CCCPRabbit/ATmega328P_VS1003_SDCARD/FreeCAD/magnet.FCStd

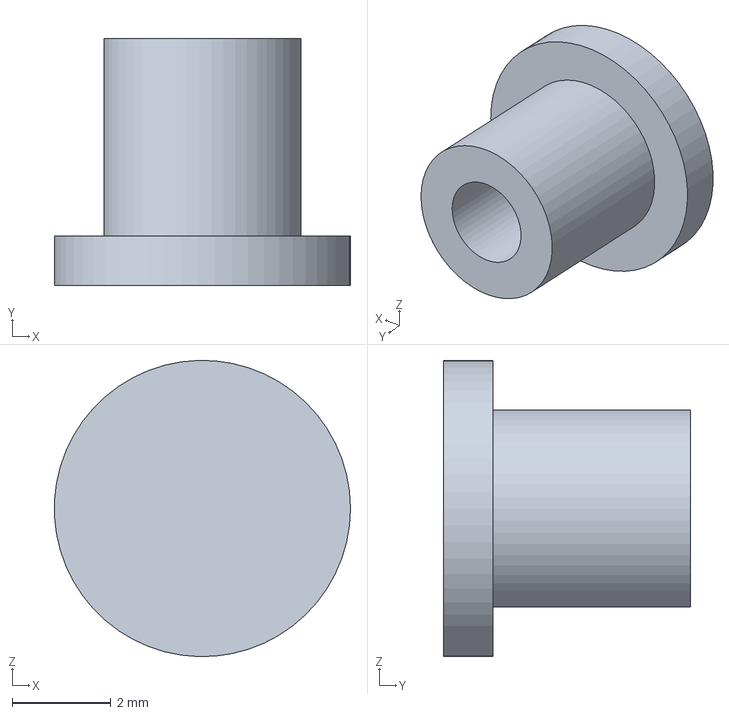
[picture p1: CAD file, 2026-07-08]
FreeCAD/magnet.FCStd
6.00 x 5.00 x 6.00 mm
