CCCPRabbit/ATmega328P_VS1003_SDCARD/(list of files, cad)

Other CAD files:
FreeCAD/magnet.3mf
