CCCPRabbit/ATmega328P_VS1003_SDCARD/KICAD/Encoder_20260515_/Encoder_20260515_.kicad_pcb

## KiCad design KICAD/Encoder_20260515_/Encoder_20260515_.kicad_pcb (2026-07-08)

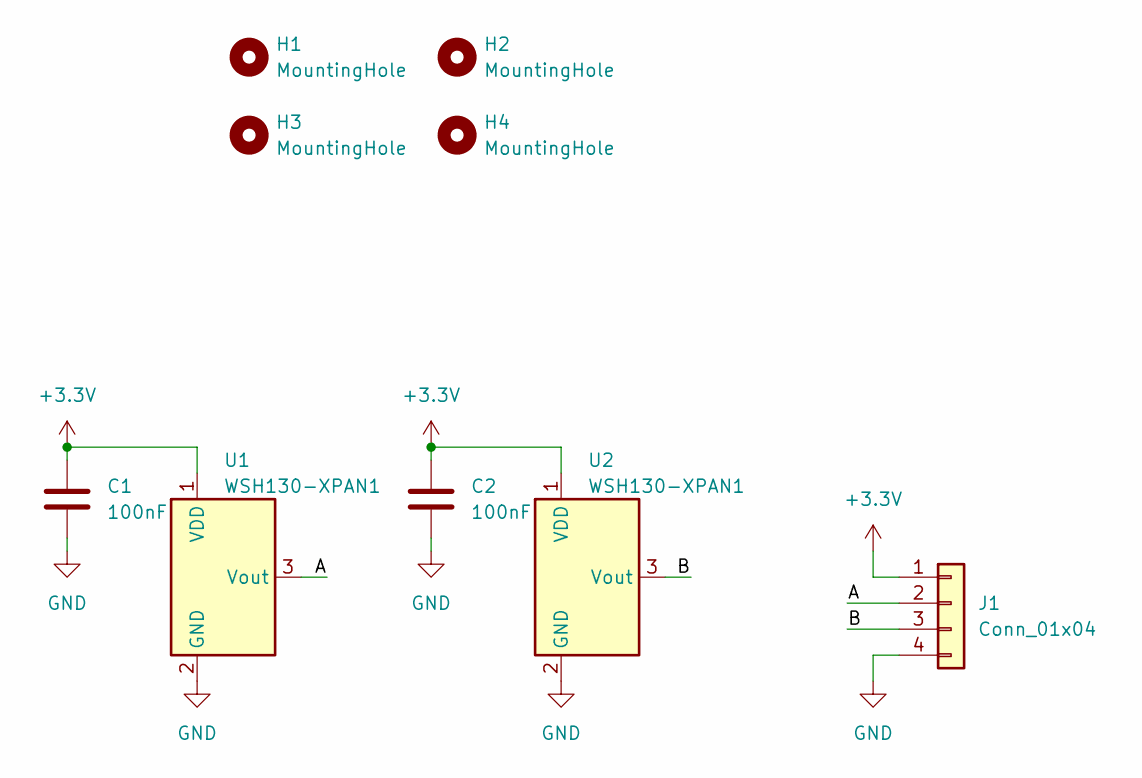
[picture p2: schematic Encoder_20260515_.kicad_sch, Encoder]

Parts:
C1, C2: 100nF; C_0603_1608Metric
H1, H2, H3, H4: MountingHole; MountingHole_2.2mm_M2
J1: Conn_01x04; Molex_PicoBlade_53047-0410_1x04_P1.25mm_Vertical
U1, U2: WSH130-XPAN1; TO-92S

Connections:
+3.3V: C1.1, C2.1, J1.1, U1.1 (VDD), U2.1 (VDD)
/A: J1.2, U1.3 (Vout)
/B: J1.3, U2.3 (Vout)
GND: C1.2, C2.2, J1.4, U1.2 (GND), U2.2 (GND)

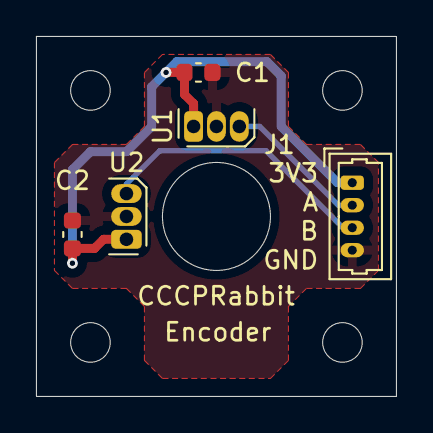
[picture p3: board Encoder_20260515_.kicad_pcb from above]

Board: 2 copper layers, 20.0 x 20.0 mm, 9 parts (0 on the bottom side), 4 nets.
