CCCPRabbit/ATmega328P_VS1003_SDCARD/KICAD/Magic_Conch_20260510_/Magic_Conch_20260510_.kicad_pcb

## KiCad design KICAD/Magic_Conch_20260510_/Magic_Conch_20260510_.kicad_pcb (2026-07-08)

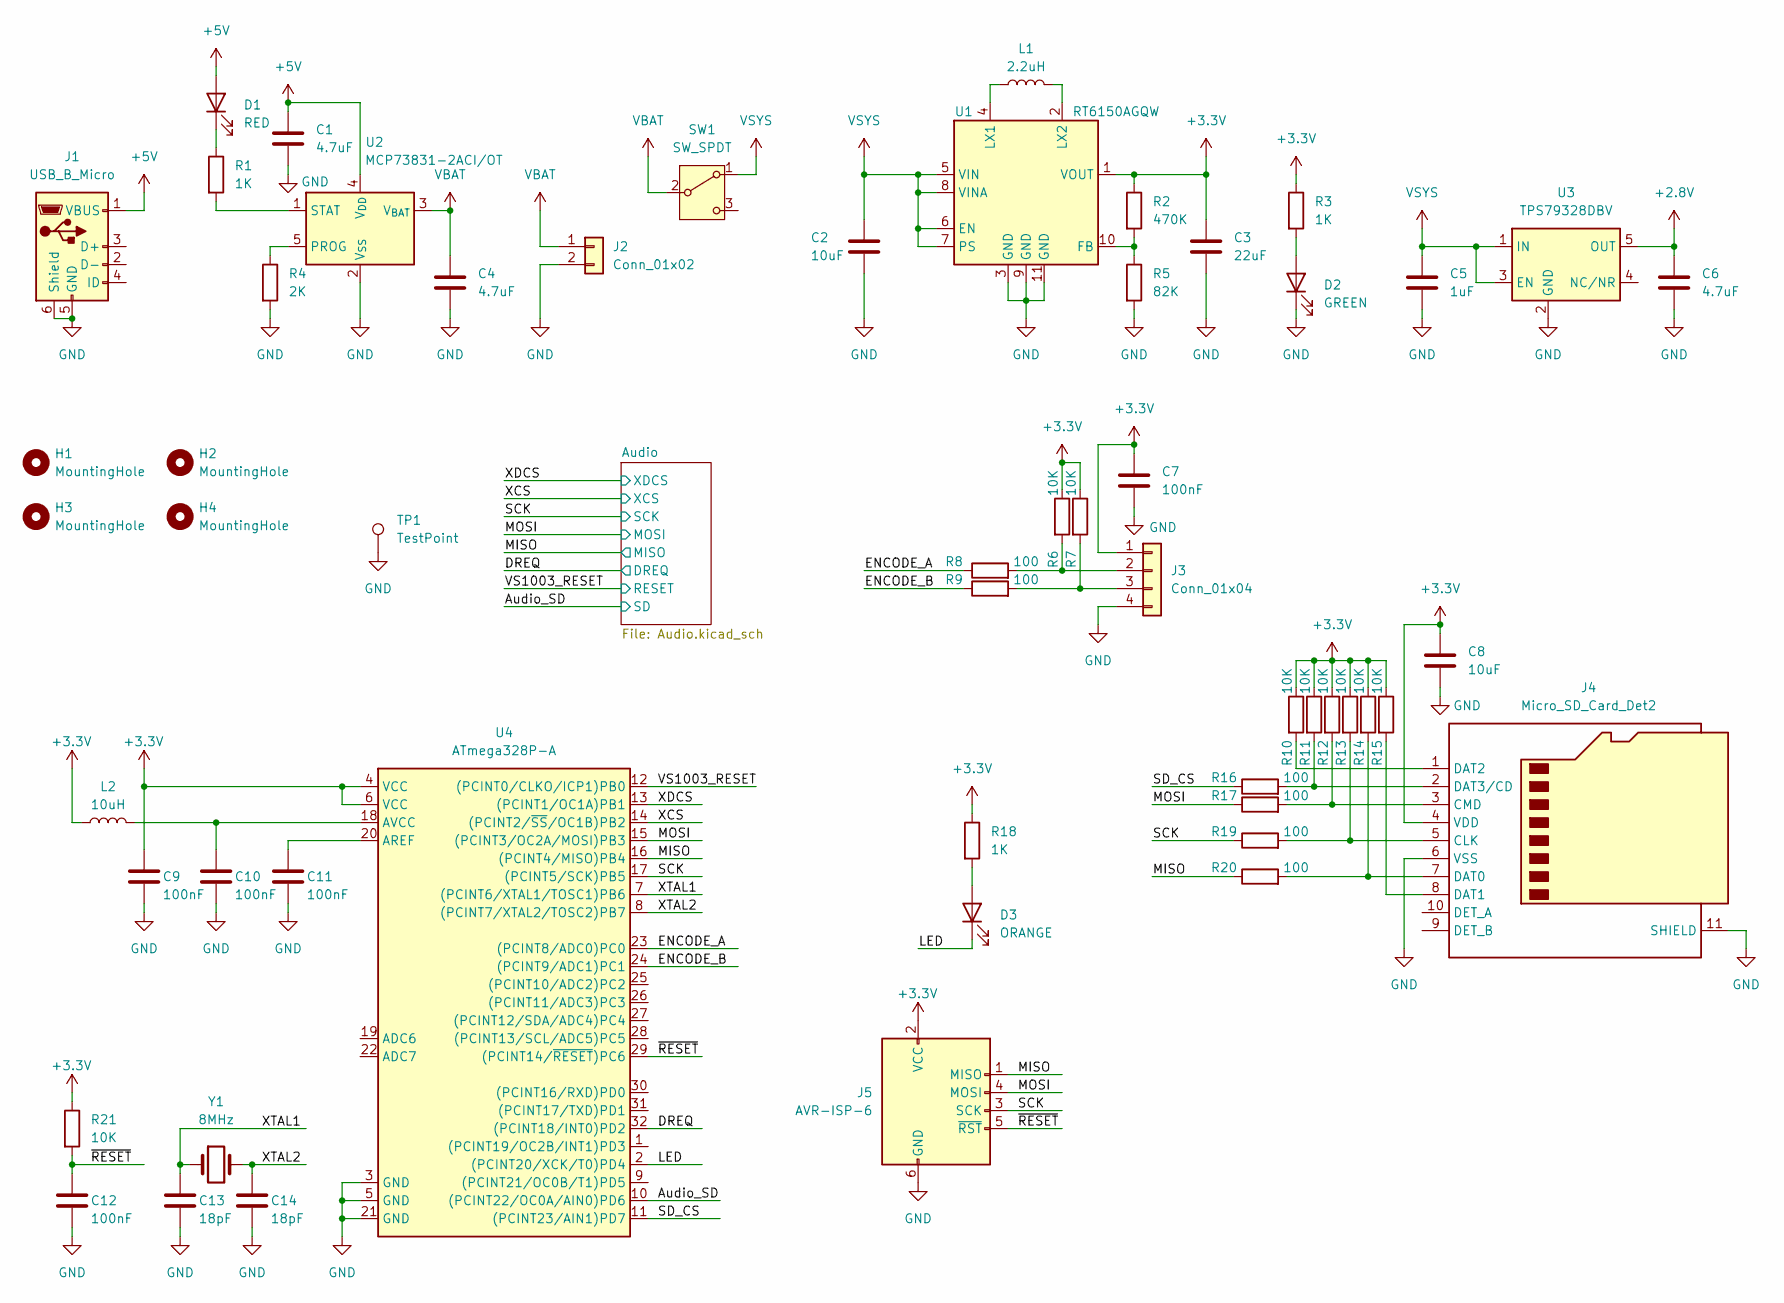
[picture p4: schematic Magic_Conch_20260510_.kicad_sch, Magic Conch]

Parts:
C1, C4, C6: 4.7uF; C_0603_1608Metric
C2, C8: 10uF; C_0603_1608Metric
C3: 22uF; C_0603_1608Metric
C5: 1uF; C_0603_1608Metric
C7, C9, C10, C11, C12: 100nF; C_0603_1608Metric
C13, C14: 18pF; C_0603_1608Metric
D1: RED; LED_0603_1608Metric
D2: GREEN; LED_0603_1608Metric
D3: ORANGE; LED_0603_1608Metric
H1, H2, H3, H4: MountingHole; MountingHole_3.2mm_M3
J1: USB_B_Micro; USB_Micro-B_Amphenol_10118194_Horizontal
J2: Conn_01x02; Molex_PicoBlade_53047-0210_1x02_P1.25mm_Vertical
J3: Conn_01x04; Molex_PicoBlade_53047-0410_1x04_P1.25mm_Vertical
J4: Micro_SD_Card_Det2; microSD_HC_Hirose_DM3AT-SF-PEJM5
J5: AVR-ISP-6; IDC-Header_2x03_P2.54mm_Vertical
L1: 2.2uH; L_1008_2520Metric
L2: 10uH; L_0603_1608Metric
R1, R3, R18: 1K; R_0603_1608Metric
R2: 470K; R_0603_1608Metric
R4: 2K; R_0603_1608Metric
R5: 82K; R_0603_1608Metric
R6, R7, R10, R11, R12, R13, R14, R15, R21: 10K; R_0603_1608Metric
R8, R9, R16, R17, R19, R20: 100; R_0603_1608Metric
SW1: SW_SPDT; MSL-1C2P(MID)-4mm
TP1: TestPoint; PinHeader_1x01_P2.54mm_Vertical
U1: RT6150AGQW; WDFN-10-1EP_3x3mm_P0.5mm_EP1.8x2.5mm
U2: MCP73831-2ACI/OT; SOT-23-5
U3: TPS79328DBV; SOT-23-5
U4: ATmega328P-A; TQFP-32_7x7mm_P0.8mm
Y1: 8MHz; Crystal_SMD_HC49-SD

Connections:
+2.8V: C6.1, U3.5 (OUT); also elsewhere on the board
+3.3V: C3.1, C7.1, C8.1, C9.1, J3.1, J4.4 (VDD), J5.2 (VCC), L2.1, R2.1, R3.1, R6.1, R7.1, R10.1, R11.1, R12.1, R13.1, R14.1, R15.1, R18.1, R21.1, U1.1 (VOUT), U4.4 (VCC), U4.6 (VCC); also elsewhere on the board
+5V: C1.1, D1.2 (A), J1.1 (VBUS), U2.4 (V_{DD})
/Audio_SD: U4.10 ((PCINT22/OC0A/AIN0)PD6); also elsewhere on the board
/DREQ: U4.32 ((PCINT18/INT0)PD2); also elsewhere on the board
/ENCODE_A: R8.1, U4.23 ((PCINT8/ADC0)PC0)
/ENCODE_B: R9.1, U4.24 ((PCINT9/ADC1)PC1)
/LED: D3.1 (K), U4.2 ((PCINT20/XCK/T0)PD4)
/MISO: J5.1 (MISO), R20.1, U4.16 ((PCINT4/MISO)PB4); also elsewhere on the board
/MOSI: J5.4 (MOSI), R17.1, U4.15 ((PCINT3/OC2A/MOSI)PB3); also elsewhere on the board
/SCK: J5.3 (SCK), R19.1, U4.17 ((PCINT5/SCK)PB5); also elsewhere on the board
/SD_CS: R16.1, U4.11 ((PCINT23/AIN1)PD7)
/VS1003_RESET: U4.12 ((PCINT0/CLKO/ICP1)PB0); also elsewhere on the board
/XCS: U4.14 ((PCINT2/~SS/OC1B)PB2); also elsewhere on the board
/XDCS: U4.13 ((PCINT1/OC1A)PB1); also elsewhere on the board
/XTAL1: C13.1, U4.7 ((PCINT6/XTAL1/TOSC1)PB6), Y1.1
/XTAL2: C14.1, U4.8 ((PCINT7/XTAL2/TOSC2)PB7), Y1.2
/~RESET: C12.1, J5.5 (~RST), R21.2, U4.29 ((PCINT14/~RESET)PC6)
GND: C1.2, C2.2, C3.2, C4.2, C5.2, C6.2, C7.2, C8.2, C9.2, C10.2, C11.2, C12.2, C13.2, C14.2, D2.1 (K), J1.5 (GND), J1.6 (Shield), J2.2, J3.4, J4.6 (VSS), J4.11 (SHIELD), J5.6 (GND), R4.2, R5.2, TP1.1, U1.3 (GND), U1.9 (GND), U1.11 (GND), U2.2 (V_{SS}), U3.2 (GND), U4.3 (GND), U4.5 (GND), U4.21 (GND); also elsewhere on the board
unnamed: D1.1 (K), R1.1
unnamed: D2.2 (A), R3.2
unnamed: D3.2 (A), R18.2
unnamed: J3.2, R6.2, R8.2
unnamed: J3.3, R7.2, R9.2
unnamed: J4.5 (CLK), R13.2, R19.2
unnamed: J4.3 (CMD), R12.2, R17.2
unnamed: J4.7 (DAT0), R14.2, R20.2
unnamed: J4.8 (DAT1), R15.2
unnamed: J4.1 (DAT2), R10.2
unnamed: J4.2 (DAT3/CD), R11.2, R16.2
unnamed: R2.2, R5.1, U1.10 (FB)
unnamed: L1.1, U1.4 (LX1)
unnamed: L1.2, U1.2 (LX2)
unnamed: R4.1, U2.5 (PROG)
unnamed: R1.2, U2.1 (STAT)
unnamed: C11.1, U4.20 (AREF)
unnamed: C10.1, L2.2, U4.18 (AVCC)
VBAT: C4.1, J2.1, SW1.2 (B), U2.3 (V_{BAT})
VSYS: C2.1, C5.1, SW1.1 (A), U1.5 (VIN), U1.6 (EN), U1.7 (PS), U1.8 (VINA), U3.1 (IN), U3.3 (EN)

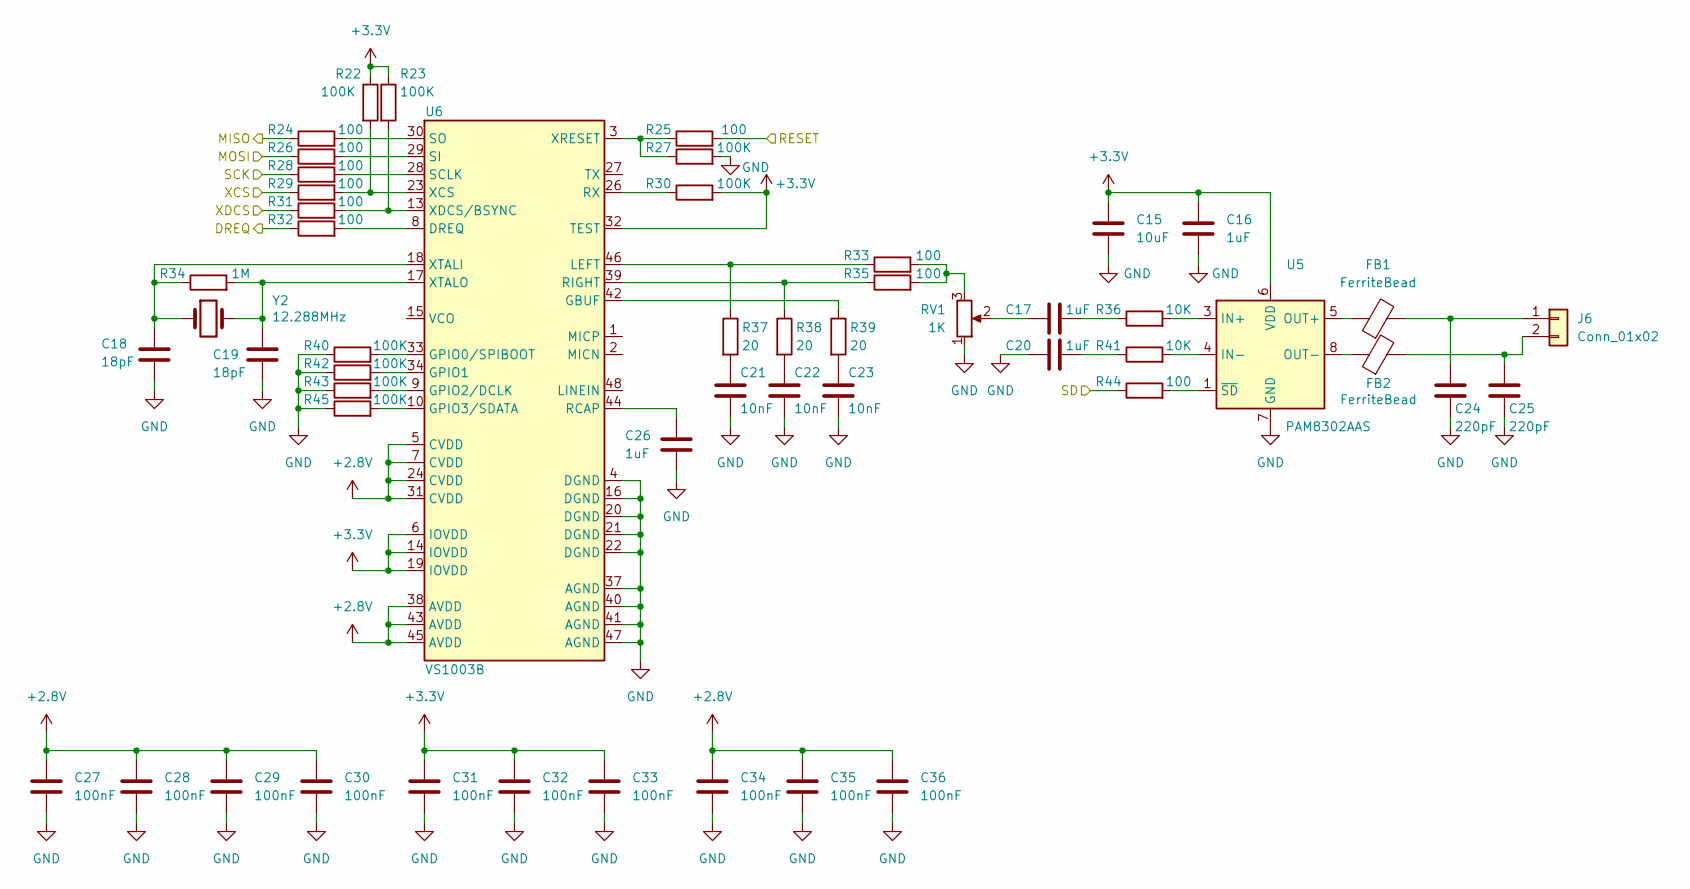
[picture p5: schematic Audio.kicad_sch]

Parts:
C15: 10uF; C_0603_1608Metric
C16, C17, C20, C26: 1uF; C_0603_1608Metric
C18, C19: 18pF; C_0603_1608Metric
C21, C22, C23: 10nF; C_0603_1608Metric
C24, C25: 220pF; C_0603_1608Metric
C27, C28, C29, C30, C31, C32, C33, C34, C35, C36: 100nF; C_0603_1608Metric
FB1, FB2: FerriteBead; L_0603_1608Metric
J6: Conn_01x02; Molex_PicoBlade_53047-0210_1x02_P1.25mm_Vertical
R22, R23, R27, R30, R40, R42, R43, R45: 100K; R_0603_1608Metric
R24, R25, R26, R28, R29, R31, R32, R33, R35, R44: 100; R_0603_1608Metric
R34: 1M; R_0603_1608Metric
R36, R41: 10K; R_0603_1608Metric
R37, R38, R39: 20; R_0603_1608Metric
RV1: 1K; Potentiometer_Bourns_3362P_Vertical
U5: PAM8302AAS; MSOP-8_3x3mm_P0.65mm
U6: VS1003B; LQFP-48_7x7mm_P0.5mm
Y2: 12.288MHz; Crystal_SMD_HC49-SD

Connections:
+2.8V: C27.1, C28.1, C29.1, C30.1, C34.1, C35.1, C36.2, U6.5 (CVDD), U6.7 (CVDD), U6.24 (CVDD), U6.31 (CVDD), U6.38 (AVDD), U6.43 (AVDD), U6.45 (AVDD); also elsewhere on the board
+3.3V: C15.1, C16.1, C31.1, C32.1, C33.1, R22.1, R23.1, R30.2, U5.6 (VDD), U6.6 (IOVDD), U6.14 (IOVDD), U6.19 (IOVDD), U6.32 (TEST); also elsewhere on the board
/Audio_SD: R44.1; also elsewhere on the board
/DREQ: R32.1; also elsewhere on the board
/MISO: R24.1; also elsewhere on the board
/MOSI: R26.1; also elsewhere on the board
/SCK: R28.1; also elsewhere on the board
/VS1003_RESET: R25.2; also elsewhere on the board
/XCS: R29.1; also elsewhere on the board
/XDCS: R31.1; also elsewhere on the board
GND: C15.2, C16.2, C18.2, C19.2, C20.1, C21.2, C22.2, C23.2, C24.2, C25.2, C26.2, C27.2, C28.2, C29.2, C30.2, C31.2, C32.2, C33.2, C34.2, C35.2, C36.1, R27.2, R40.1, R42.1, R43.1, R45.1, RV1.1, U5.7 (GND), U6.4 (DGND), U6.16 (DGND), U6.20 (DGND), U6.21 (DGND), U6.22 (DGND), U6.37 (AGND), U6.40 (AGND), U6.41 (AGND), U6.47 (AGND); also elsewhere on the board
unnamed: C17.1, RV1.2
unnamed: C17.2, R36.1
unnamed: C20.2, R41.1
unnamed: C21.1, R37.2
unnamed: C22.1, R38.2
unnamed: C23.1, R39.2
unnamed: C24.1, FB1.2, J6.1
unnamed: C25.1, FB2.2, J6.2
unnamed: R33.2, R35.2, RV1.3
unnamed: R36.2, U5.3 (IN+)
unnamed: R41.2, U5.4 (IN-)
unnamed: FB1.1, U5.5 (OUT+)
unnamed: FB2.1, U5.8 (OUT-)
unnamed: R44.2, U5.1 (~SD)
unnamed: R32.2, U6.8 (DREQ)
unnamed: R39.1, U6.42 (GBUF)
unnamed: R40.2, U6.33 (GPIO0/SPIBOOT)
unnamed: R42.2, U6.34 (GPIO1)
unnamed: R43.2, U6.9 (GPIO2/DCLK)
unnamed: R45.2, U6.10 (GPIO3/SDATA)
unnamed: R33.1, R37.1, U6.46 (LEFT)
unnamed: C26.1, U6.44 (RCAP)
unnamed: R35.1, R38.1, U6.39 (RIGHT)
unnamed: R30.1, U6.26 (RX)
unnamed: R28.2, U6.28 (SCLK)
unnamed: R26.2, U6.29 (SI)
unnamed: R24.2, U6.30 (SO)
unnamed: R22.2, R29.2, U6.23 (XCS)
unnamed: R23.2, R31.2, U6.13 (XDCS/BSYNC)
unnamed: R25.1, R27.1, U6.3 (XRESET)
unnamed: C18.1, R34.1, U6.18 (XTALI), Y2.1
unnamed: C19.1, R34.2, U6.17 (XTALO), Y2.2

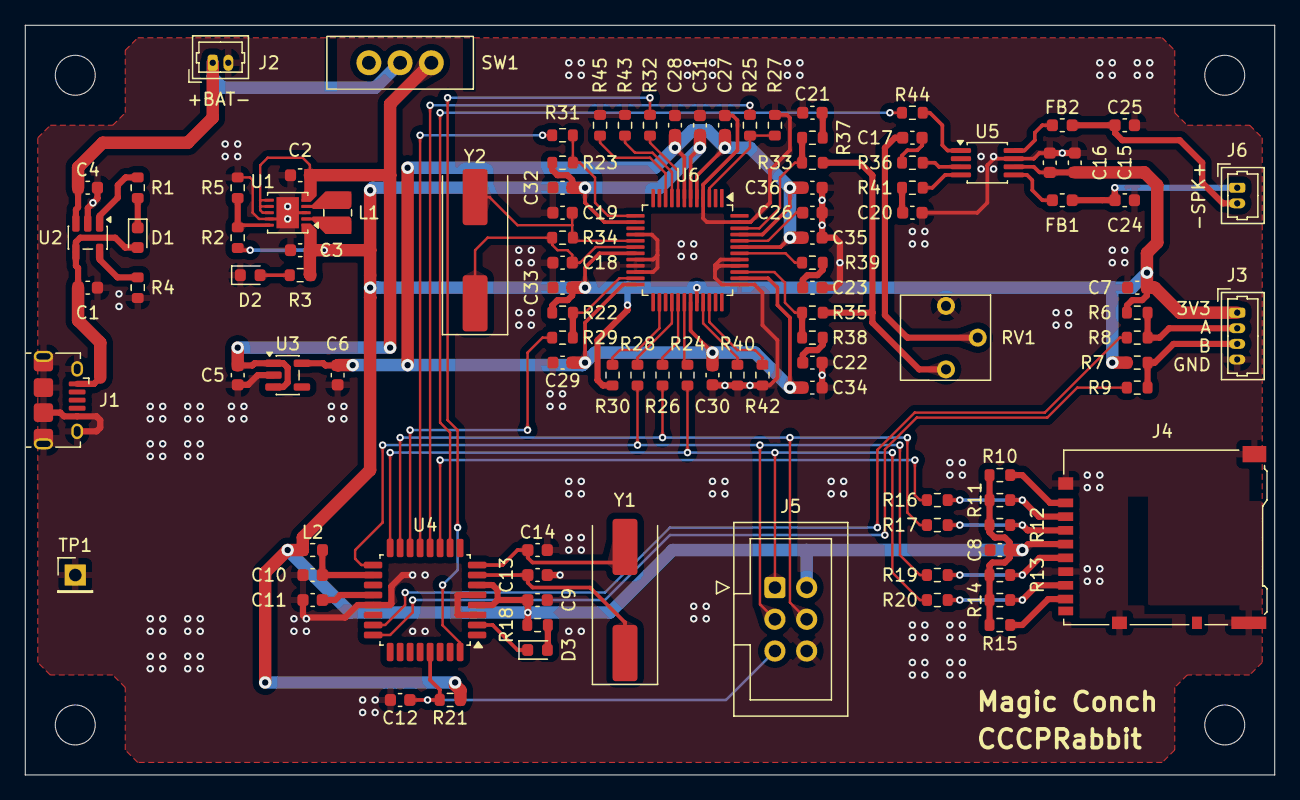
[picture p6: board Magic_Conch_20260510_.kicad_pcb from above]

Board: 2 copper layers, 100.0 x 60.0 mm, 109 parts (0 on the bottom side), 71 nets.
