CCCPRabbit/ATmega328P_VS1003_SDCARD/AVR/Magic_Conch/mmc_avr.h

/*-----------------------------------------------------------------------
/  Low level disk interface modlue include file   (C)ChaN, 2016
/-----------------------------------------------------------------------*/

#ifndef _MMC_AVR_H
#define _MMC_AVR_H

#include "ff.h"
#include "diskio.h"

#ifdef __cplusplus
extern "C" {
#endif

/*---------------------------------------*/
/* Prototypes for disk control functions */

DSTATUS mmc_disk_initialize (void);
DSTATUS mmc_disk_status (void);
DRESULT mmc_disk_read (BYTE* buff, LBA_t sector, UINT count);
DRESULT mmc_disk_write (const BYTE* buff, LBA_t sector, UINT count);
DRESULT mmc_disk_ioctl (BYTE cmd, void* buff);
void mmc_disk_timerproc (void);

#ifdef __cplusplus
}
#endif

#endif
